Jianan-Li/Handheld-Tetris-Game/README.md

# Handheld-Tetris-Game

Click <a href="http://www.jianan.li/handheld-tetris-game">here</a> for more info on this project.
