Jianan-Li/Handheld-Tetris-Game/Electrical Design/Tetris.brd

## EAGLE design Electrical Design/Tetris.brd (2016-12-03)

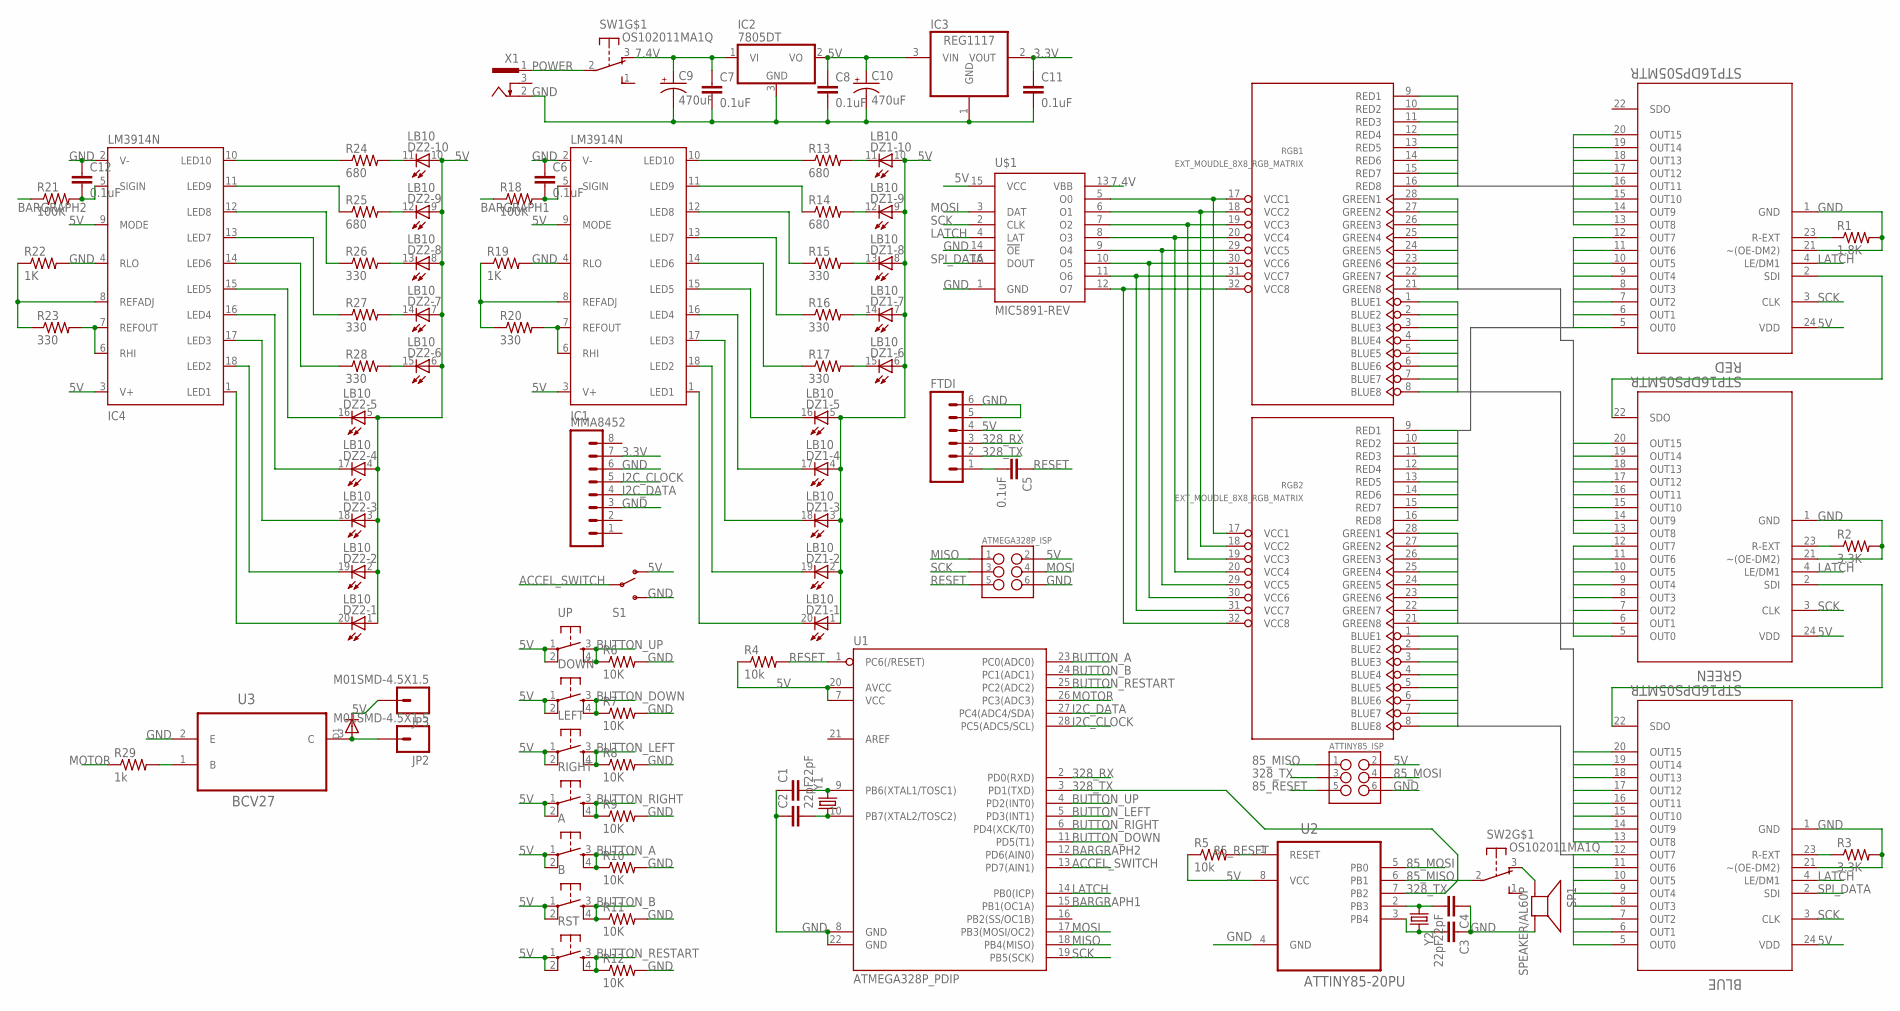
[picture p1: schematic Tetris.sch]

Parts:
A: TAC_SWITCHPTH; TACTILE-PTH
ATMEGA328P_ISP: M03X22X3_SILK_SM; 2X3
ATTINY85_ISP: M03X22X3_SILK_SM; 2X3
B: TAC_SWITCHPTH; TACTILE-PTH
BLUE: STP16DPS05MTR; SOIC127P1032X265-24N
C1, C2, C3, C4: 22pF; 0805
C5, C6, C7, C8, C11, C12: 0.1uF; 0805
C9, C10: 470uF; PANASONIC_D
D1: DIODESMA; SMADIODE
DOWN: TAC_SWITCHPTH; TACTILE-PTH
DZ1, DZ2: LB10
FTDI: M06LOCK; 1X06_LOCK
GREEN: STP16DPS05MTR; SOIC127P1032X265-24N
IC1, IC4: LM3914N; DIL18
IC2: 7805DT; TO252
IC3: REG1117; SOT223
JP2, JP3: M01SMD-4.5X1.5; PAD-1.5X4.5
LEFT: TAC_SWITCHPTH; TACTILE-PTH
MMA8452: M08LOCK; 1X08_LOCK
R1: 1.8K; 0805
R2, R3: 3.3K; 0805
R4, R5: 10k; 0805
R6, R7, R8, R9, R10, R11, R12: 10K; 0805
R13, R14, R24, R25: 680; 0805
R15, R16, R17, R20, R23, R26, R27, R28: 330; 0805
R18, R21: 100K; 0805
R19, R22: 1K; 0805
R29: 1k; 0805
RED: STP16DPS05MTR; SOIC127P1032X265-24N
RGB1, RGB2: EXT_MOUDLE_8X8_RGB_MATRIX
RIGHT: TAC_SWITCHPTH; TACTILE-PTH
RST: TAC_SWITCHPTH; TACTILE-PTH
S1: SWITCH-SPDTPTH_LOCK; SWITCH-SPDT_LOCK.007S
SP1: SPEAKER/AL60P; AL60P
SW1, SW2: OS102011MA1Q
U1: ATMEGA328P_PDIP; DIL28-3
U2: ATTINY85-20PU; DIP254P762X533-8
U3: BCV27; SOT95P230X93-3N
U$1: MIC5891-REV; DIL16
UP: TAC_SWITCHPTH; TACTILE-PTH
X1: 733989-5
Y1, Y2: CRYSTALHC49US; HC49US

Connections:
3.3V: C11.1, IC3.2 (VOUT), MMA8452.7
5V: A.1, A.2, ATMEGA328P_ISP.2, ATTINY85_ISP.2, B.1, B.2, BLUE.24 (VDD), C8.1, C10.+, D1.C, DOWN.1, DOWN.2, DZ1.1 (A), DZ1.2 (A), DZ1.3 (A), DZ1.4 (A), DZ1.5 (A), DZ1.6 (A), DZ1.7 (A), DZ1.8 (A), DZ1.9 (A), DZ1.10 (A), DZ2.1 (A), DZ2.2 (A), DZ2.3 (A), DZ2.4 (A), DZ2.5 (A), DZ2.6 (A), DZ2.7 (A), DZ2.8 (A), DZ2.9 (A), DZ2.10 (A), FTDI.4, GREEN.24 (VDD), IC1.3 (V+), IC1.9 (MODE), IC2.2 (VO), IC3.3 (VIN), IC4.3 (V+), IC4.9 (MODE), JP3.P$1, LEFT.1, LEFT.2, R4.1, R5.1, RED.24 (VDD), RIGHT.1, RIGHT.2, RST.1, RST.2, S1.1 (O), U1.7 (VCC), U1.20 (AVCC), U2.8 (VCC), U$1.15 (VCC), UP.1, UP.2
7.4V: C7.1, C9.+, IC2.1 (VI), SW1.3 (O), U$1.13 (VBB)
85_MISO: ATTINY85_ISP.1, SW2.2, U2.6 (PB1)
85_MOSI: ATTINY85_ISP.4, U2.5 (PB0)
85_RESET: ATTINY85_ISP.5, R5.2, U2.1 (RESET)
328_RX: FTDI.3, U1.2 (PD0(RXD))
328_TX: ATTINY85_ISP.3, FTDI.2, U1.3 (PD1(TXD)), U2.7 (PB2)
ACCEL_SWITCH: S1.2, U1.13 (PD7(AIN1))
BARGRAPH1: R18.1, U1.15 (PB1(OC1A))
BARGRAPH2: R21.1, U1.12 (PD6(AIN0))
BLUE1: BLUE.20 (OUT15), RGB1.8 (BLUE8)
BLUE2: BLUE.19 (OUT14), RGB1.7 (BLUE7)
BLUE3: BLUE.18 (OUT13), RGB1.6 (BLUE6)
BLUE4: BLUE.17 (OUT12), RGB1.5 (BLUE5)
BLUE5: BLUE.16 (OUT11), RGB1.4 (BLUE4)
BLUE6: BLUE.15 (OUT10), RGB1.3 (BLUE3)
BLUE7: BLUE.14 (OUT9), RGB1.2 (BLUE2)
BLUE8: BLUE.13 (OUT8), RGB1.1 (BLUE1)
BLUE9: BLUE.12 (OUT7), RGB2.8 (BLUE8)
BLUE10: BLUE.11 (OUT6), RGB2.7 (BLUE7)
BLUE11: BLUE.10 (OUT5), RGB2.6 (BLUE6)
BLUE12: BLUE.9 (OUT4), RGB2.5 (BLUE5)
BLUE13: BLUE.8 (OUT3), RGB2.4 (BLUE4)
BLUE14: BLUE.7 (OUT2), RGB2.3 (BLUE3)
BLUE15: BLUE.6 (OUT1), RGB2.2 (BLUE2)
BLUE16: BLUE.5 (OUT0), RGB2.1 (BLUE1)
BUTTON_A: A.3, A.4, R10.1, U1.23 (PC0(ADC0))
BUTTON_B: B.3, B.4, R11.1, U1.24 (PC1(ADC1))
BUTTON_DOWN: DOWN.3, DOWN.4, R7.1, U1.11 (PD5(T1))
BUTTON_LEFT: LEFT.3, LEFT.4, R8.1, U1.5 (PD3(INT1))
BUTTON_RESTART: R12.1, RST.3, RST.4, U1.25 (PC2(ADC2))
BUTTON_RIGHT: R9.1, RIGHT.3, RIGHT.4, U1.6 (PD4(XCK/T0))
BUTTON_UP: R6.1, U1.4 (PD2(INT0)), UP.3, UP.4
GND: ATMEGA328P_ISP.6, ATTINY85_ISP.6, BLUE.1 (GND), BLUE.21 (~(OE-DM2)), C1.1, C2.1, C3.1, C4.1, C6.1, C7.2, C8.2, C9.-, C10.-, C11.2, C12.1, FTDI.5, FTDI.6, GREEN.1 (GND), GREEN.21 (~(OE-DM2)), IC1.2 (V-), IC1.4 (RLO), IC2.3 (GND), IC3.1 (GND), IC4.2 (V-), IC4.4 (RLO), MMA8452.3, MMA8452.6, R1.2, R2.2, R3.2, R6.2, R7.2, R8.2, R9.2, R10.2, R11.2, R12.2, R19.2, R22.2, RED.1 (GND), RED.21 (~(OE-DM2)), S1.3 (S), SP1.2 (-), U1.8 (GND), U1.22 (GND), U2.4 (GND), U3.2 (E), U$1.1 (GND), U$1.14 (!OE), X1.2
GREEN1: GREEN.20 (OUT15), RGB1.21 (GREEN8)
GREEN2: GREEN.19 (OUT14), RGB1.22 (GREEN7)
GREEN3: GREEN.18 (OUT13), RGB1.23 (GREEN6)
GREEN4: GREEN.17 (OUT12), RGB1.24 (GREEN5)
GREEN5: GREEN.16 (OUT11), RGB1.25 (GREEN4)
GREEN6: GREEN.15 (OUT10), RGB1.26 (GREEN3)
GREEN7: GREEN.14 (OUT9), RGB1.27 (GREEN2)
GREEN8: GREEN.13 (OUT8), RGB1.28 (GREEN1)
GREEN9: GREEN.12 (OUT7), RGB2.21 (GREEN8)
GREEN10: GREEN.11 (OUT6), RGB2.22 (GREEN7)
GREEN11: GREEN.10 (OUT5), RGB2.23 (GREEN6)
GREEN12: GREEN.9 (OUT4), RGB2.24 (GREEN5)
GREEN13: GREEN.8 (OUT3), RGB2.25 (GREEN4)
GREEN14: GREEN.7 (OUT2), RGB2.26 (GREEN3)
GREEN15: GREEN.6 (OUT1), RGB2.27 (GREEN2)
GREEN16: GREEN.5 (OUT0), RGB2.28 (GREEN1)
I2C_CLOCK: MMA8452.5, U1.28 (PC5(ADC5/SCL))
I2C_DATA: MMA8452.4, U1.27 (PC4(ADC4/SDA))
LATCH: BLUE.4 (LE/DM1), GREEN.4 (LE/DM1), RED.4 (LE/DM1), U1.14 (PB0(ICP)), U$1.4 (LAT)
MISO: ATMEGA328P_ISP.1, U1.18 (PB4(MISO))
MOSI: ATMEGA328P_ISP.4, U1.17 (PB3(MOSI/OC2)), U$1.3 (DAT)
MOTOR: R29.1, U1.26 (PC3(ADC3))
unnamed: R1.1, RED.23 (R-EXT)
unnamed: RGB1.18 (VCC2), RGB2.18 (VCC2), U$1.6 (O1)
unnamed: RGB1.19 (VCC3), RGB2.19 (VCC3), U$1.7 (O2)
unnamed: RGB1.20 (VCC4), RGB2.20 (VCC4), U$1.8 (O3)
unnamed: RGB1.29 (VCC5), RGB2.29 (VCC5), U$1.9 (O4)
unnamed: RGB1.30 (VCC6), RGB2.30 (VCC6), U$1.10 (O5)
unnamed: RGB1.31 (VCC7), RGB2.31 (VCC7), U$1.11 (O6)
unnamed: RGB1.32 (VCC8), RGB2.32 (VCC8), U$1.12 (O7)
unnamed: C5.2, FTDI.1
unnamed: DZ1.15 (C), R17.2
unnamed: C1.2, U1.9 (PB6(XTAL1/TOSC1)), Y1.2
unnamed: C2.2, U1.10 (PB7(XTAL2/TOSC2)), Y1.1
unnamed: C3.2, U2.3 (PB4), Y2.2
unnamed: C4.2, U2.2 (PB3), Y2.1
unnamed: DZ1.14 (C), R16.2
unnamed: DZ1.13 (C), R15.2
unnamed: GREEN.22 (SDO), RED.2 (SDI)
unnamed: GREEN.23 (R-EXT), R2.1
unnamed: RGB1.17 (VCC1), RGB2.17 (VCC1), U$1.5 (O0)
unnamed: DZ1.12 (C), R14.2
unnamed: DZ1.11 (C), R13.2
unnamed: BLUE.22 (SDO), GREEN.2 (SDI)
unnamed: IC1.10 (LED10), R13.1
unnamed: BLUE.23 (R-EXT), R3.1
unnamed: IC1.11 (LED9), R14.1
unnamed: IC1.12 (LED8), R15.1
unnamed: IC1.13 (LED7), R16.1
unnamed: IC1.14 (LED6), R17.1
unnamed: DZ1.16 (C), IC1.15 (LED5)
unnamed: DZ1.17 (C), IC1.16 (LED4)
unnamed: DZ1.18 (C), IC1.17 (LED3)
unnamed: DZ1.19 (C), IC1.18 (LED2)
unnamed: DZ1.20 (C), IC1.1 (LED1)
unnamed: C6.2, IC1.5 (SIGIN), R18.2
unnamed: IC1.8 (REFADJ), R19.1, R20.1
unnamed: IC1.6 (RHI), IC1.7 (REFOUT), R20.2
unnamed: IC4.11 (LED9), R25.1
unnamed: IC4.12 (LED8), R26.1
unnamed: IC4.13 (LED7), R27.1
unnamed: IC4.14 (LED6), R28.1
unnamed: DZ2.16 (C), IC4.15 (LED5)
unnamed: DZ2.17 (C), IC4.16 (LED4)
unnamed: DZ2.18 (C), IC4.17 (LED3)
unnamed: DZ2.19 (C), IC4.18 (LED2)
unnamed: DZ2.20 (C), IC4.1 (LED1)
unnamed: C12.2, IC4.5 (SIGIN), R21.2
unnamed: IC4.8 (REFADJ), R22.1, R23.1
unnamed: IC4.6 (RHI), IC4.7 (REFOUT), R23.2
unnamed: IC4.10 (LED10), R24.1
unnamed: DZ2.15 (C), R28.2
unnamed: DZ2.14 (C), R27.2
unnamed: DZ2.13 (C), R26.2
unnamed: DZ2.12 (C), R25.2
unnamed: DZ2.11 (C), R24.2
unnamed: R29.2, U3.1 (B)
unnamed: D1.A, JP2.P$1, U3.3 (C)
unnamed: SP1.1 (+), SW2.3 (O)
POWER: SW1.2, X1.1
RED1: RED.20 (OUT15), RGB1.16 (RED8)
RED2: RED.19 (OUT14), RGB1.15 (RED7)
RED3: RED.18 (OUT13), RGB1.14 (RED6)
RED4: RED.17 (OUT12), RGB1.13 (RED5)
RED5: RED.16 (OUT11), RGB1.12 (RED4)
RED6: RED.15 (OUT10), RGB1.11 (RED3)
RED7: RED.14 (OUT9), RGB1.10 (RED2)
RED8: RED.13 (OUT8), RGB1.9 (RED1)
RED9: RED.12 (OUT7), RGB2.16 (RED8)
RED10: RED.11 (OUT6), RGB2.15 (RED7)
RED11: RED.10 (OUT5), RGB2.14 (RED6)
RED12: RED.9 (OUT4), RGB2.13 (RED5)
RED13: RED.8 (OUT3), RGB2.12 (RED4)
RED14: RED.7 (OUT2), RGB2.11 (RED3)
RED15: RED.6 (OUT1), RGB2.10 (RED2)
RED16: RED.5 (OUT0), RGB2.9 (RED1)
RESET: ATMEGA328P_ISP.5, C5.1, R4.2, U1.1 (PC6(/RESET))
SCK: ATMEGA328P_ISP.3, BLUE.3 (CLK), GREEN.3 (CLK), RED.3 (CLK), U1.19 (PB5(SCK)), U$1.2 (CLK)
SPI_DATA: BLUE.2 (SDI), U$1.16 (DOUT)

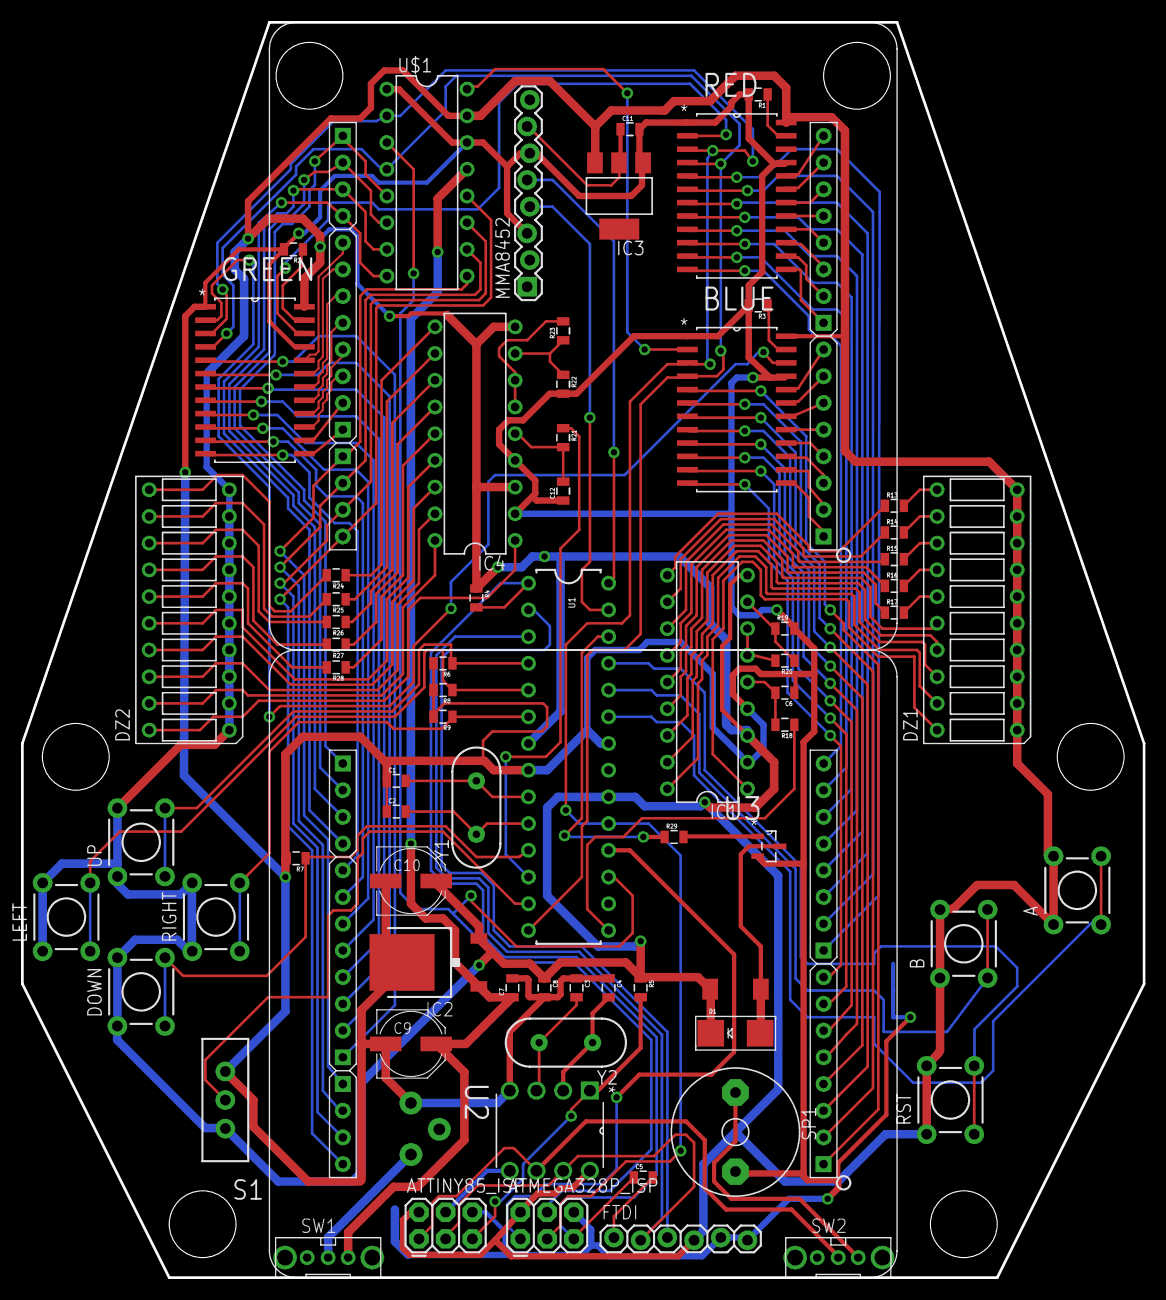
[picture p2: board Tetris.brd from above]

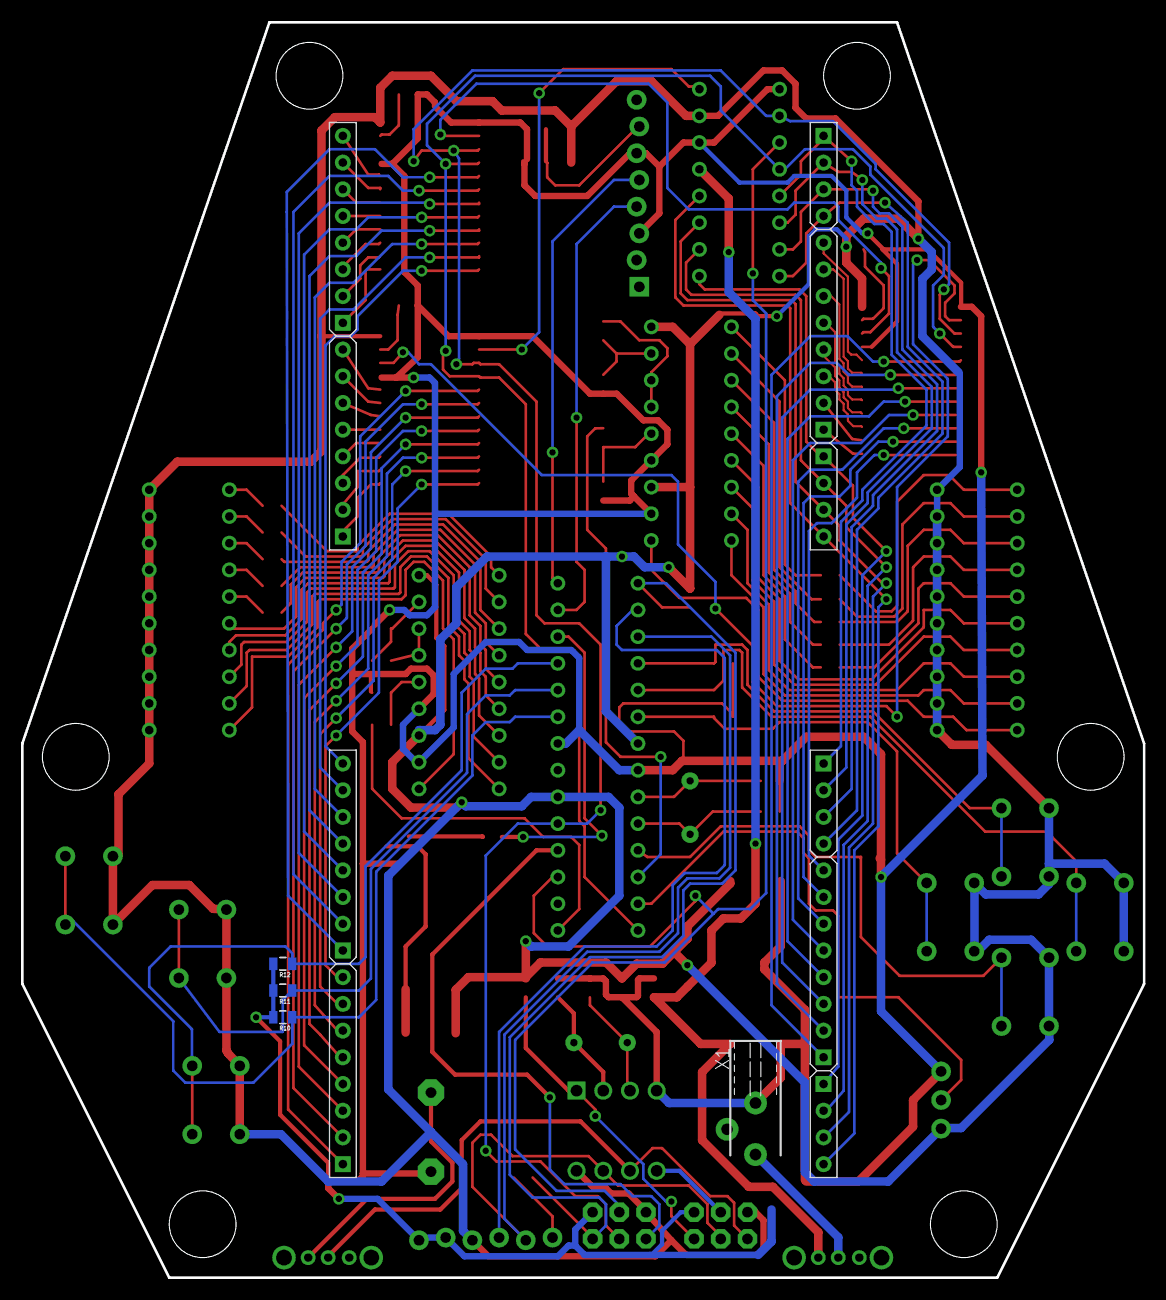
[picture p3: board Tetris.brd from below]

Board: 2 copper layers, 106.7 x 119.4 mm, 77 parts (4 on the bottom side), 134 nets.
