Jianan-Li/Handheld-Tetris-Game/(notices)

Notices in the files:
parts and their libraries:
Edeca.net: This is v1 and is licensed under the Creative Commons (Attribution-Non-Commercial-Share Alike 2.0 UK)
SparkFun-Connectors: Licensing: CC v3.0 Share-Alike You are welcome to use this library for commercial purposes.
